UCSD-Quadcopter-Class/quad-hardware-group3-tawfic-michael/quadcopter.brd

## EAGLE design quadcopter.brd (2017-05-18)

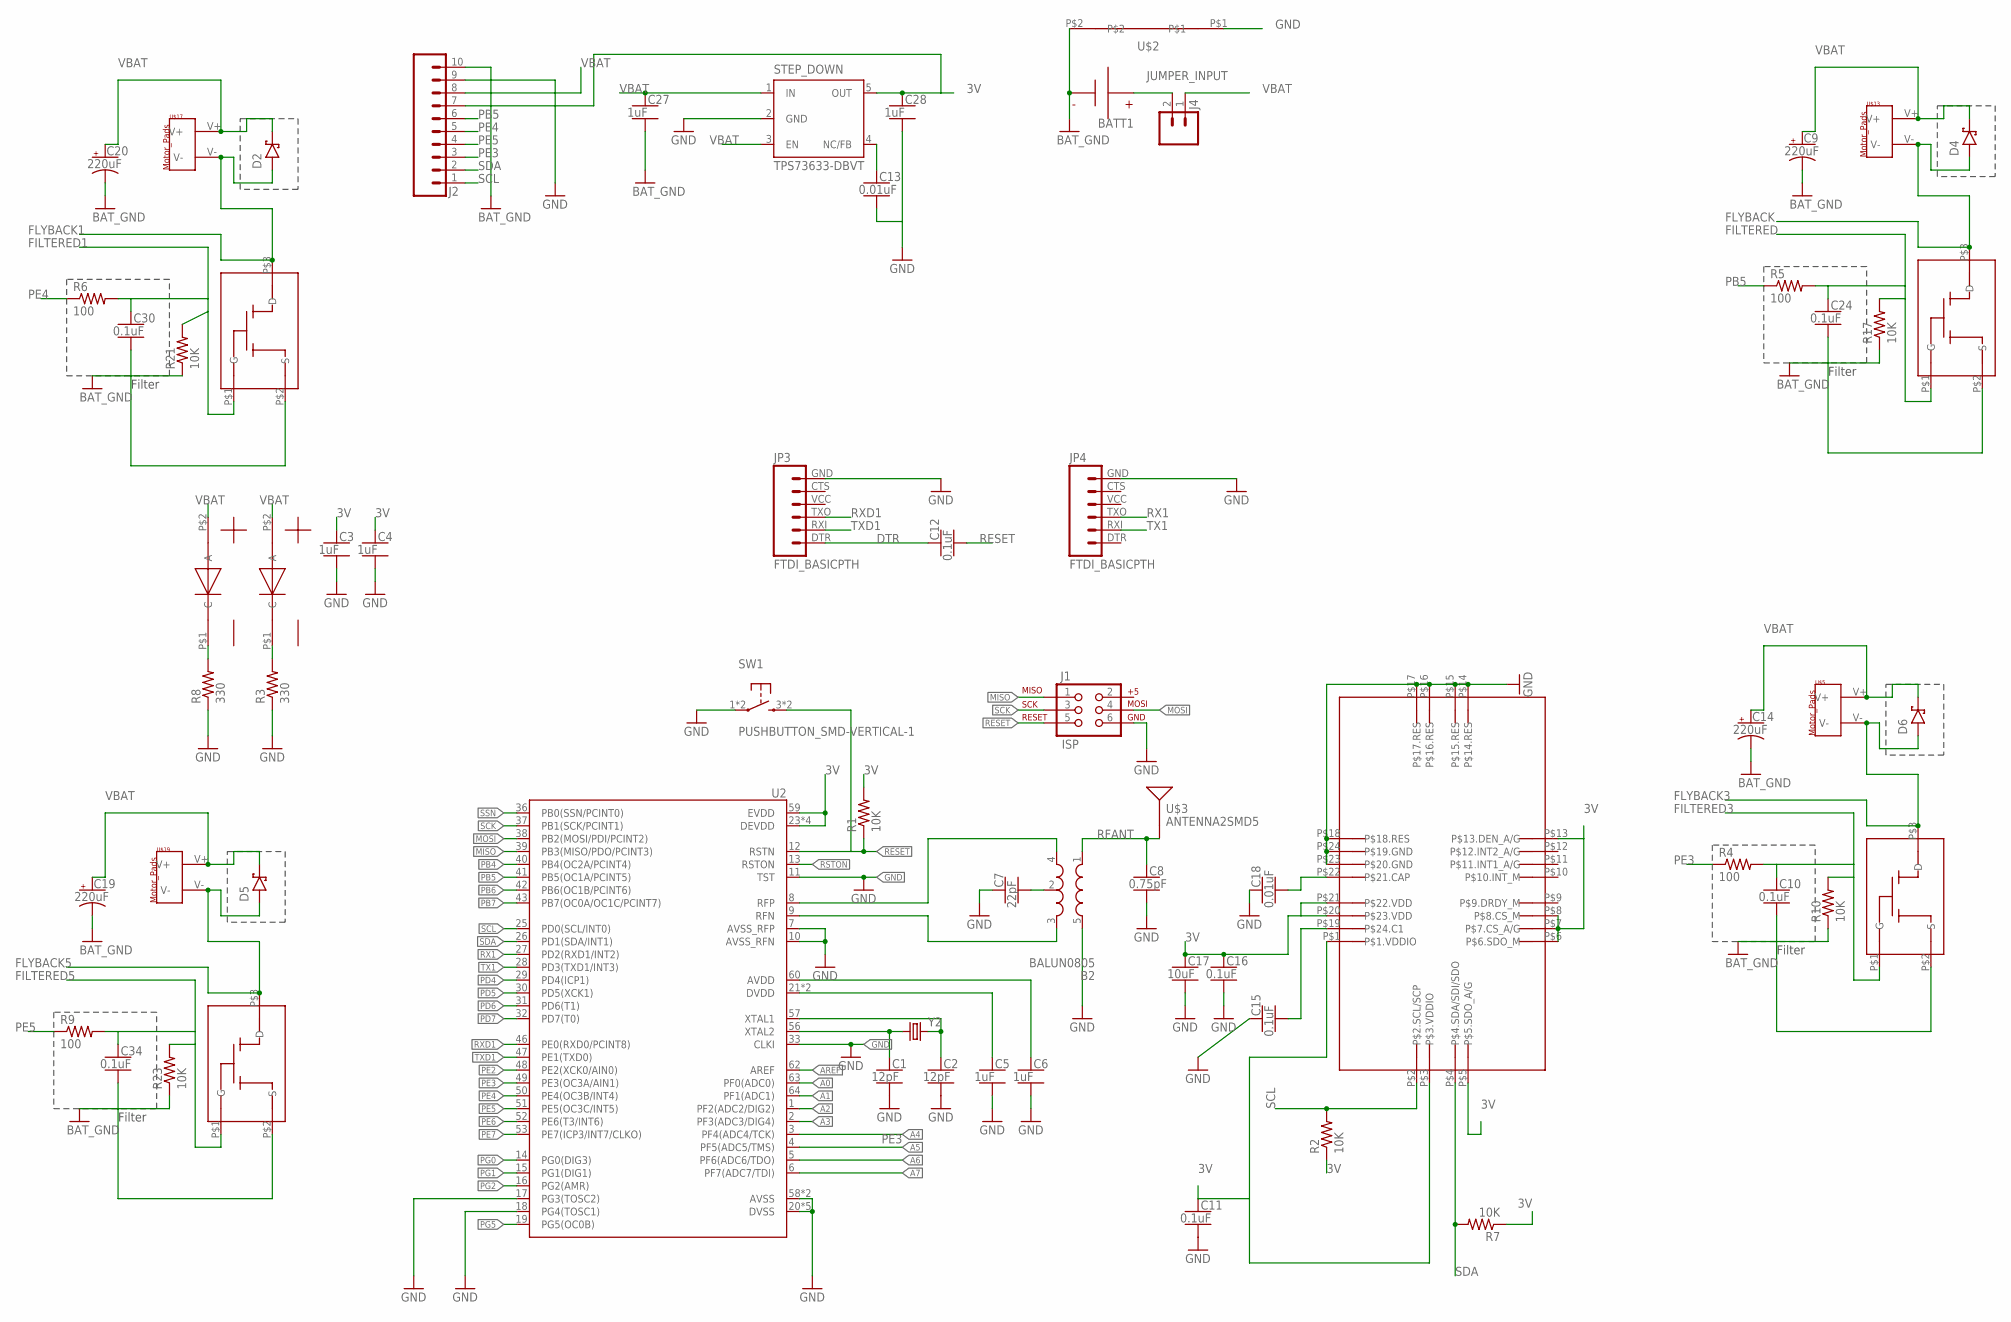
[picture p1: schematic quadcopter.sch]

Parts:
B2: BALUN0805; BALUN
BATT1: BATTERY-HUBSAN-W/HOLDER; BATTERY-W/HOLDER-380MAH-HUBSAN
C1, C2: 12pF; CAPC2012X140_HS
C3, C4, C5, C6, C27, C28: 1uF; CAPC2012X140_HS
C7: 22pF; CAPC2012X140_HS
C8: 0.75pF; CAPC2012X140_HS
C9, C14, C19, C20: 220uF; CAPMP7343X310_HS
C10, C11, C12, C15, C16, C24, C30, C34: 0.1uF; CAPC2012X140_HS
C13, C18: 0.01uF; CAPC2012X140_HS
C17: 10uF; CAPC2012X140_HS
D1, D3: LED-RED; RED_LED
D2, D4, D5, D6: DIODE-SCHOTTKY_SMD-SOD123; SOD3716X135_HS
J1: ISP; 2X3-NS
J2: SIP-10_TH-254X10-1; HDRV10W63P254_10X1_2540X254H838_HS
J4: MALE_HEADER_2POS-2X1-0.1IN; MALE_HEADER_2X1_0.1IN
JP3, JP4: FTDI_BASICPTH; FTDI_BASIC
R1, R2, R7, R10, R17, R21, R23: 10K; RESC2012X60_HS
R3, R8: 330; RESC2012X60_HS
R4, R5, R6, R9: 100; RESC2012X60_HS
STEP_DOWN: TPS73633-DBVT; SOT23-DBV
SW1: PUSHBUTTON_SMD-VERTICAL-1; TE_FSM8JSMA_HS
U2: ATMEGA128RFA1; QFN-64
U$1: LSM9DS1TR_IMU-9_AXIS; IMU
U$2: NET_BRIDGE
U$3: ANTENNA2SMD5; ANTENNA-CHIP5
U$5, U$13, U$17, U$19: MOTOR_PADS
U$7, U$16, U$18, U$20: MOSFET-N_CHANNEL; MOSFET
Y2: CRYSTAL5X3; CRYSTAL-SMD-5X3

Connections:
3V: C3.1, C4.1, C11.1, C16.1, C17.1, C28.1, J2.7, R1.2, R2.1, R7.1, STEP_DOWN.5 (OUT), U2.23 (DEVDD), U2.34 (DEVDD), U2.44 (DEVDD), U2.54 (DEVDD), U2.59 (EVDD), U$1.P$1 (P$1.VDDIO), U$1.P$3 (P$3.VDDIO), U$1.P$5 (P$5.SDO_A/G), U$1.P$6 (P$6.SDO_M), U$1.P$7 (P$7.CS_A/G), U$1.P$8 (P$8.CS_M), U$1.P$13 (P$13.DEN_A/G), U$1.P$20 (P$23.VDD), U$1.P$21 (P$22.VDD)
A0: U2.63 (PF0(ADC0))
A1: U2.64 (PF1(ADC1))
A2: U2.1 (PF2(ADC2/DIG2))
A3: U2.2 (PF3(ADC3/DIG4))
A4: U2.3 (PF4(ADC4/TCK))
A5: U2.4 (PF5(ADC5/TMS))
A6: U2.5 (PF6(ADC6/TDO))
A7: U2.6 (PF7(ADC7/TDI))
AREF: U2.62 (AREF)
AVDD: C6.1, U2.60 (AVDD)
BAT_GND: BATT1.- (N), C9.2 (-), C10.2, C14.2 (-), C19.2 (-), C20.2 (-), C24.2, C27.2, C30.2, C34.2, J2.10, R10.1, R17.1, R21.1, R23.1, U$2.P$2, U$7.P$2 (S), U$16.P$2 (S), U$18.P$2 (S), U$20.P$2 (S)
DTR: C12.1, JP3.DTR (1)
DVDD: C5.1, U2.21 (DVDD), U2.22 (DVDD)
FILTERED: C24.1, R5.2, R17.2, U$16.P$1 (G)
FILTERED1: C30.1, R6.2, R21.2, U$18.P$1 (G)
FILTERED3: C10.1, R4.2, R10.2, U$7.P$1 (G)
FILTERED5: C34.1, R9.2, R23.2, U$20.P$1 (G)
FLYBACK: D4.A, U$13.V-, U$16.P$3 (D)
FLYBACK1: D2.A, U$17.V-, U$18.P$3 (D)
FLYBACK3: D6.A, U$5.V-, U$7.P$3 (D)
FLYBACK5: D5.A, U$19.V-, U$20.P$3 (D)
GND: B2.5 (GND), C1.2, C2.2, C3.2, C4.2, C5.2, C6.2, C7.1, C8.2, C11.2, C13.2, C15.1, C16.2, C17.2, C18.1, C28.2, J1.6, J2.9, JP3.GND (6), JP4.GND (6), R3.1, R8.1, STEP_DOWN.2 (GND), SW1.1, SW1.2 (1), U2.7 (AVSS_RFP), U2.10 (AVSS_RFN), U2.11 (TST), U2.17 (PG3(TOSC2)), U2.18 (PG4(TOSC1)), U2.20 (DVSS), U2.24 (DVSS), U2.33 (CLKI), U2.35 (DVSS), U2.45 (DVSS), U2.55 (DVSS), U2.58 (AVSS), U2.61 (AVSS), U$1.P$14 (P$14.RES), U$1.P$15 (P$15.RES), U$1.P$16 (P$16.RES), U$1.P$17 (P$17.RES), U$1.P$18 (P$18.RES), U$1.P$23 (P$20.GND), U$1.P$24 (P$19.GND), U$2.P$1
JUMPER_INPUT: BATT1.+, J4.2
MISO: J1.1, U2.39 (PB3(MISO/PDO/PCINT3))
MOSI: J1.4, U2.38 (PB2(MOSI/PDI/PCINT2))
unnamed: C13.1, STEP_DOWN.4 (NC/FB)
unnamed: C2.1, U2.57 (XTAL1), Y2.3 (2)
unnamed: C1.1, U2.56 (XTAL2), Y2.1
unnamed: C18.2, U$1.P$22 (P$21.CAP)
unnamed: C15.2, U$1.P$19 (P$24.C1)
unnamed: B2.2 (GND), C7.2
unnamed: D3.P$1 (C), R8.2
unnamed: D1.P$1 (C), R3.2
PB4: U2.40 (PB4(OC2A/PCINT4))
PB5: J2.6, R5.1, U2.41 (PB5(OC1A/PCINT5))
PB6: U2.42 (PB6(OC1B/PCINT6))
PB7: U2.43 (PB7(OC0A/OC1C/PCINT7))
PD4: U2.29 (PD4(ICP1))
PD5: U2.30 (PD5(XCK1))
PD6: U2.31 (PD6(T1))
PD7: U2.32 (PD7(T0))
PE2: U2.48 (PE2(XCK0/AIN0))
PE3: J2.3, R4.1, U2.49 (PE3(OC3A/AIN1))
PE4: J2.5, R6.1, U2.50 (PE4(OC3B/INT4))
PE5: J2.4, R9.1, U2.51 (PE5(OC3C/INT5))
PE6: U2.52 (PE6(T3/INT6))
PE7: U2.53 (PE7(ICP3/INT7/CLKO))
PG0: U2.14 (PG0(DIG3))
PG1: U2.15 (PG1(DIG1))
PG2: U2.16 (PG2(AMR))
PG5: U2.19 (PG5(OC0B))
RESET: C12.2, J1.5, R1.1, SW1.3 (2), SW1.4 (2), U2.12 (RSTN)
RFANT: B2.1 (IN), C8.1, U$3.FEED
RFN: B2.3 (OUT2), U2.9 (RFN)
RFP: B2.4 (OUT1), U2.8 (RFP)
RSTON: U2.13 (RSTON)
RX1: JP4.TXO (3), U2.27 (PD2(RXD1/INT2))
RXD1: JP3.TXO (3), U2.46 (PE0(RXD0/PCINT8))
SCK: J1.3, U2.37 (PB1(SCK/PCINT1))
SCL: J2.1, R2.2, U2.25 (PD0(SCL/INT0)), U$1.P$2 (P$2.SCL/SCP)
SDA: J2.2, R7.2, U2.26 (PD1(SDA/INT1)), U$1.P$4 (P$4.SDA/SDI/SDO)
SSN: U2.36 (PB0(SSN/PCINT0))
TX1: JP4.RXI (2), U2.28 (PD3(TXD1/INT3))
TXD1: JP3.RXI (2), U2.47 (PE1(TXD0))
VBAT: C9.1 (+), C14.1 (+), C19.1 (+), C20.1 (+), C27.1, D1.P$2 (A), D2.C, D3.P$2 (A), D4.C, D5.C, D6.C, J2.8, J4.1, STEP_DOWN.1 (IN), STEP_DOWN.3 (EN), U$5.V+, U$13.V+, U$17.V+, U$19.V+

Notes on the sheet:
Filter

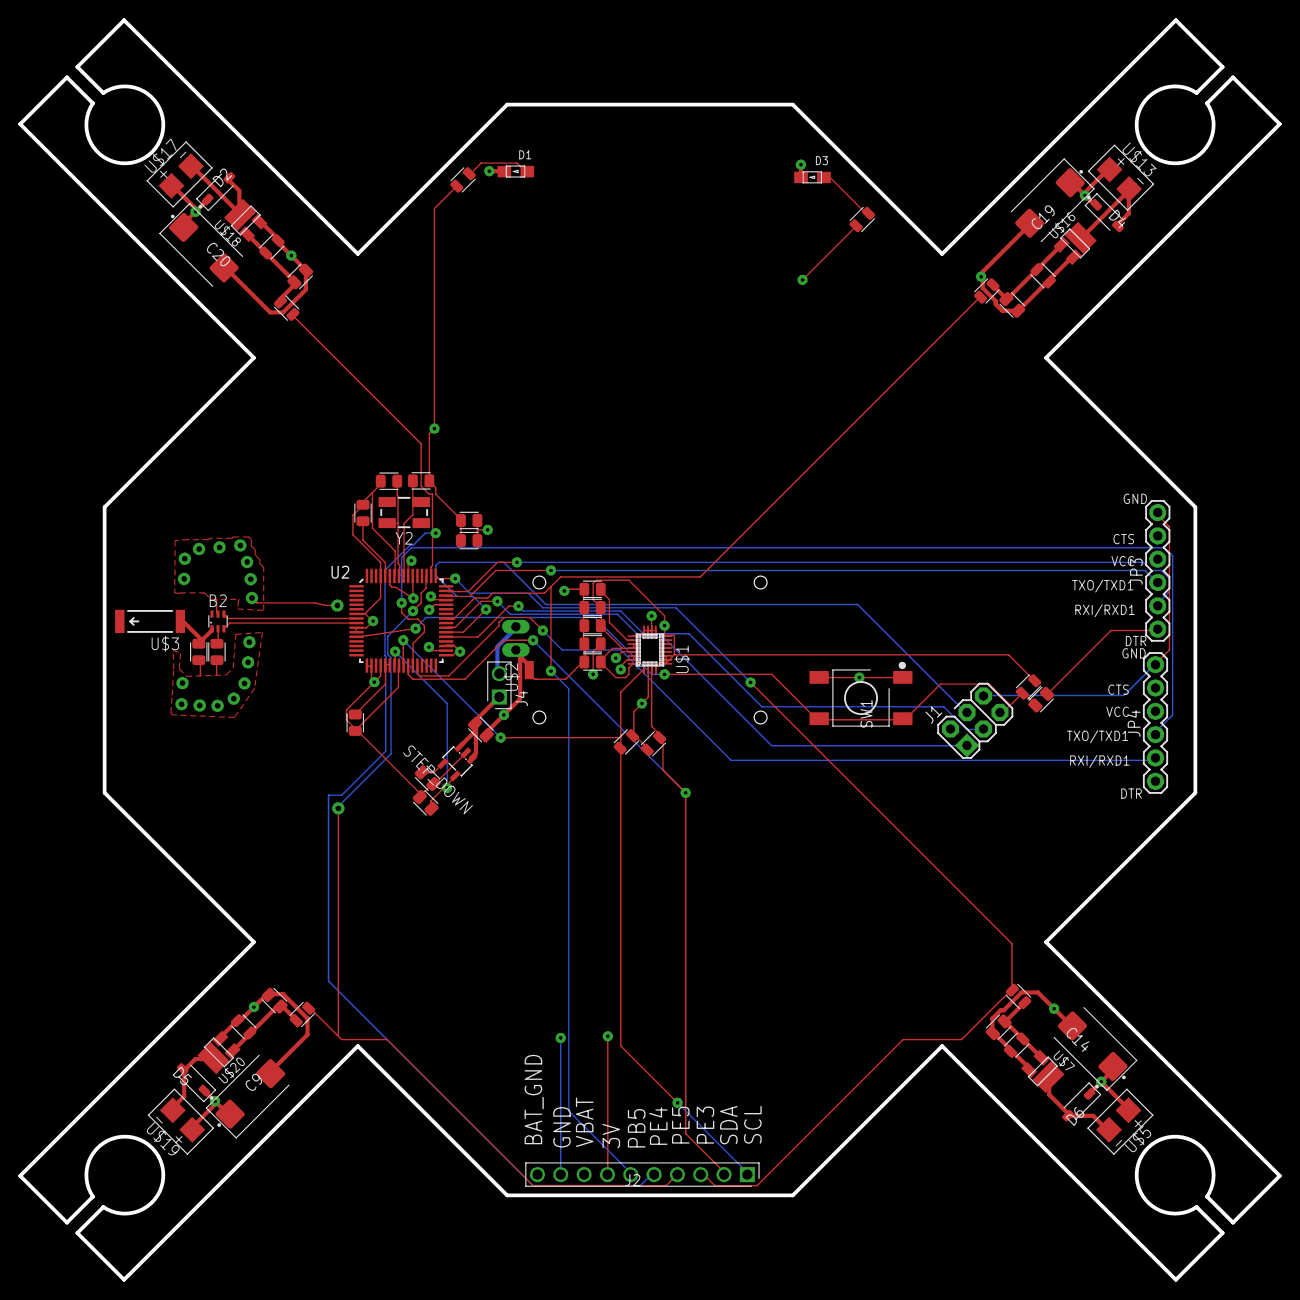
[picture p2: board quadcopter.brd from above]

Board: 4 copper layers, 137.2 x 137.2 mm, 66 parts (1 on the bottom side), 41 nets.
