UCSD-Quadcopter-Class/quad-hardware-group3-tawfic-michael/(commit log)

2017-04-19 Worked through the microcontroller section, but didn't finish part 4. also think I need to replace their microcontroller
    [quadcopter.sch]
2017-04-20 added motor and header
    [quadcopter_tawfic.sch]
2017-04-20 almost forgot to include schematic
    [quadcopter.sch]
2017-04-27 instructior review of original schematic
2017-04-30 fixed stuff from design review
    [quadcopter.sch]
2017-05-02 trying to work with pour, but can't move to internal layer. don't know why :(
    [quadcopter.brd, quadcopter.sch]
2017-05-02 figured out pour, finished the gnd layer. need to continue from 3v and vbat pours
    [quadcopter.brd]
2017-05-02 fixed arm length
2017-05-03 There surely are a ton of mistakes, but I'm not sure what they are. I had to do a ton of routing by hand
    [quadcopter.brd, quadcopter.sch]
2017-05-14 more schematic comments from swanson
2017-05-16 routed and everything
    [quadcopter.brd, quadcopter.sch]
2017-05-16 worked on routing more, there are still lots of drc issues though
    [quadcopter.brd, quadcopter.sch]
2017-05-16 Board comments from swanson
2017-05-16 autorouting works, things are good
    [quadcopter.brd, quadcopter.sch]
2017-05-17 almost forgot newest board and schematic
    [quadcopter.brd, quadcopter.sch]
2017-05-17 bigger mosfet pads, no vias leading to oscillator, cap 28 and 13 (?) go to gnd instead of bat_gnd, made antenna better
    [quadcopter.brd, quadcopter.sch]
2017-05-17 changed most gnds on regulator to gnd instead of bat_gnd
    [quadcopter.brd, quadcopter.sch]
2017-05-17 i think i forgot some airwires in last commit
    [quadcopter.brd]
2017-05-18 moved net bridge and VREG closer to battery terminals
    [quadcopter.brd]
2017-05-18 fixed drc things for closer net bridge
    [quadcopter.brd]
2017-05-18 made vreg traces even shorter
    [quadcopter.brd]
2017-05-18 rotated board to fit in box
    [quadcopter.brd]
