UCSD-Quadcopter-Class/quad-hardware-group3-tawfic-michael/(notices)

Notices in the files:
parts and their libraries:
SparkFun-Aesthetics: Licensing: CC v3.0 Share-Alike You are welcome to use this library for commercial purposes.
SparkFun-Aesthetics: Released under the Creative Commons
SparkFun-Aesthetics: http://creativecommons.org/licenses/by-sa/3.0
